realhuno/Chorus32-ESP32LapTimer/pcb/smeat/esp32-wroom-timer-v1/esp32-wroom-timer_bottom.png

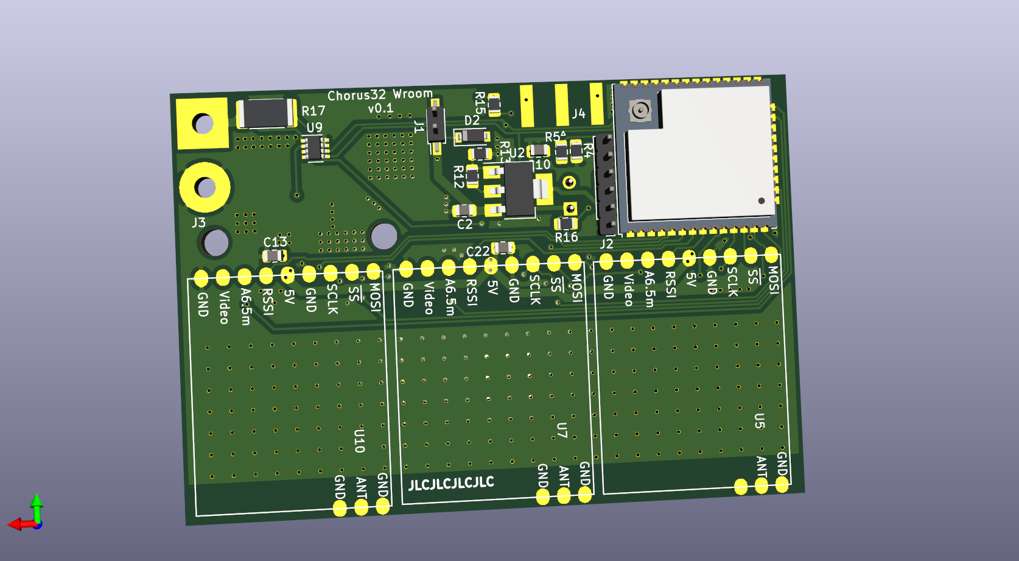
pcb/smeat/esp32-wroom-timer-v1/esp32-wroom-timer_bottom.png
