realhuno/Chorus32-ESP32LapTimer/ESP32LapTimer/src/targets/config_default.h

#define BEEPER 14

#define LEDs 12

#define BUTTON1 T7 // 27
#define BUTTON2 T4 // 13

#define CS1 16
#define CS2 5
#define CS3 4
#define CS4 15
#define CS5 25
#define CS6 26

#define ADC1 ADC1_CHANNEL_0
#define ADC2 ADC1_CHANNEL_3
#define ADC3 ADC1_CHANNEL_6
#define ADC4 ADC1_CHANNEL_7
#define ADC5 ADC1_CHANNEL_4
#define ADC6 ADC1_CHANNEL_5

#define ADC1_GPIO 36
#define ADC2_GPIO 39
#define ADC3_GPIO 34
#define ADC4_GPIO 35
#define ADC5_GPIO 32
#define ADC6_GPIO 33

#define OLED
#define OLED_SCL 21
#define OLED_SDA 22
