realhuno/Chorus32-ESP32LapTimer/LapRelay/HardwareConfig.h

#define MAX_UDP_CLIENTS 5
#define WIFI_AP_NAME "Chorus32 LapTimer Relay"
#define BLUETOOTH_NAME WIFI_AP_NAME

#define USE_BLUETOOTH
//#define USE_SERIAL

//#define OUTPUT_DEBUG
//#define INPUT_DEBUG


#define USE_LORA
#define LORA_SCK 5
#define LORA_MISO 19
#define LORA_MOSI 27
#define LORA_CS 18
#define LORA_RST 14
#define LORA_IRQ 26
#define LORA_FREQ 866E6
