realhuno/Chorus32-ESP32LapTimer/ESP32LapTimer/src/targets/config_ttgo_lora_v1.h

#define BEEPER 4

#define LEDs 2

#define USE_CLASSIC_BUTTONS

#define BUTTON1 13
#define BUTTON2 12

#define VRX_MOSI 23
#define VRX_SCK 25

#define CS1 16
#define CS2 4
#define CS3 4
#define CS4 4
#define CS5 4
#define CS6 4

#define ADC1 ADC1_CHANNEL_0
#define ADC2 ADC1_CHANNEL_3
#define ADC3 ADC1_CHANNEL_6
#define ADC4 ADC1_CHANNEL_5
#define ADC5 ADC1_CHANNEL_4
#define ADC6 ADC1_CHANNEL_7 // switched with adc 4 due to xtal

#define ADC1_GPIO 36
#define ADC2_GPIO 39
#define ADC3_GPIO 34
#define ADC4_GPIO 33
#define ADC5_GPIO 32
#define ADC6_GPIO 35

#define USE_LORA
#define LORA_SCK 5
#define LORA_MISO 19
#define LORA_MOSI 27
#define LORA_CS 18
#define LORA_RST 14
#define LORA_IRQ 26
#define LORA_FREQ 866E6
