realhuno/Chorus32-ESP32LapTimer/ESP32LapTimer/src/targets/config_wroom.h

#define BEEPER 18

#define LEDs 16

#define VRX_SCK 26
#define VRX_MOSI 14

#define CS1 25
#define CS2 27
#define CS3 13
#define CS4 12
#define CS5 15
#define CS6 2

#define ADC1 ADC1_CHANNEL_5
#define ADC2 ADC1_CHANNEL_4
#define ADC3 ADC1_CHANNEL_7
#define ADC4 ADC1_CHANNEL_6
#define ADC5 ADC1_CHANNEL_0
#define ADC6 ADC1_CHANNEL_3

#define ADC1_GPIO 33
#define ADC2_GPIO 32
#define ADC3_GPIO 35
#define ADC4_GPIO 34
#define ADC5_GPIO 36
#define ADC6_GPIO 39

#define I2C_SDA 23
#define I2C_SCL 22

#ifdef OLED
#undef OLED
#endif
