realhuno/Chorus32-ESP32LapTimer/ESP32LapTimer/src/targets/config_dev_board.h

#define BEEPER 0

#define LEDs 0

#define BUTTON1 T7 // 27
#define BUTTON2 T4 // 13

#define CS1 16
#define CS2 5
#define CS4 4
#define CS3 15
#define CS5 0
#define CS6 0

#define ADC1 ADC1_CHANNEL_0
#define ADC2 ADC1_CHANNEL_3
#define ADC4 ADC1_CHANNEL_6
#define ADC3 ADC1_CHANNEL_7
#define ADC5 ADC1_CHANNEL_7
#define ADC6 ADC1_CHANNEL_5

#define ADC1_GPIO 36
#define ADC2_GPIO 39
#define ADC3_GPIO 34
#define ADC4_GPIO 35
#define ADC5_GPIO 32
#define ADC6_GPIO 33

#define USE_LORA
#define LORA_SCK 17
#define LORA_MISO 32
#define LORA_MOSI 26
#define LORA_CS 12
#define LORA_RST 14
#define LORA_IRQ 25
#define LORA_FREQ 866E6
