realhuno/Chorus32-ESP32LapTimer/ESP32LapTimer/src/RX5808.cpp

#define SPI_ADDRESS_SYNTH_B 0x01
#define SPI_ADDRESS_POWER   0x0A
#define SPI_ADDRESS_STATE   0x0F

#define PowerDownState    0b11111111111111111111
#define DefaultPowerState 0b00010000110000010011

#define ResetReg          0b00000000000000000000
#define StandbyReg        0b00000000000000000010
#define PowerOnReg        0b00000000000000000001

#define PD_VCLAMP       0x00080000 /*Video clamp power down control */
#define PD_VAMP         0x00040000 /*Video amp power down control */
#define PD_IF_DEMOD     0x00020000 /*IF demodulator power down control */
#define PD_IFAF         0x00010000 /*IFAF power down control */
#define PD_RSSI_SQUELCH 0x00008000 /*RSSI & noise squelch power down control */
#define PD_REGBS        0x00004000 /*BS regulator power down control */
#define PD_REGIF        0x00002000 /*IF regulator power down control */
#define PD_BC           0x00001000 /*BC power down control */
#define PD_DIV4         0x00000800 /*Divide-by-4 power down control */
#define PD_5GVCO        0x00000400 /*5G VCO power down control */
#define PD_SYN          0x00000200 /*SYN power down control */
#define PD_AU6M         0x00000100 /*6M audio modulator power down control */
#define PD_6M           0x00000080 /*6M power down control */
#define PD_AU6M5        0x00000040 /*6M5 audio modulator power down control */
#define PD_6M5          0x00000020 /*6M5 power down control */
#define PD_REG1D8       0x00000010 /*1.8V regulator power down control */
#define PD_IFABF        0x00000008 /*IFABF power down control */
#define PD_MIXER        0x00000004 /*RF Mixer power down control */
#define PD_DIV80        0x00000002 /*Divide-by-80 power down control */
#define PD_PLL1D8       0x00000001 /*PLL 1.8V regulator power down control */

//                       PD_VCLAMP | PD_VAMP | PD_IF_DEMOD | PD_IFAF | PD_REGIF | PD_DIV4 | PD_5GVCO | PD_SYN | PD_AU6M | PD_6M | PD_AU6M5 | PD_6M5 | PD_REG1D8 | PD_IFABF | PD_MIXER | PD_DIV80 | PD_PLL1D8

// PD_IF_DEMOD, PD_REGIF, PD_IFABF, PD_MIXER, PD_REGBS, PD_RSSI_SQUELCH, PD_BC breaks rssi
// PD_SYN decreases rssi extremely. not really usable
// saves about 10mA
#define LOW_POWER_STATE (PD_VCLAMP | PD_VAMP | PD_IFAF | PD_DIV4 | PD_5GVCO | PD_AU6M | PD_6M | PD_AU6M5 | PD_6M5 | PD_REG1D8 | PD_DIV80 | PD_PLL1D8)

#include "RX5808.h"

#include "HardwareConfig.h"
#include "settings_eeprom.h"

#include <Arduino.h>
#include <stdint.h>
#include <SPI.h>
#include <driver/timer.h>

static volatile uint8_t RXBandModule[MAX_NUM_RECEIVERS];
static volatile uint8_t RXChannelModule[MAX_NUM_RECEIVERS];

// TODO: this doesn't really belong here
static volatile uint8_t RXBandPilot[MAX_NUM_PILOTS];
static volatile uint8_t RXChannelPilot[MAX_NUM_PILOTS];

static uint32_t lastUpdate[MAX_NUM_RECEIVERS] = {0,0,0,0,0,0};

void InitSPI() {
  SPI.begin(VRX_SCK, VRX_MISO, VRX_MOSI);
  delay(200);
  // Reset all modules to ensure they come back online in case they were offline without a power cycle (pressing the reset button)
  RXResetAll();
  delay(30);
  rxLowPowerAll();
  delay(30);
}

bool IRAM_ATTR isRxReady(uint8_t module) {
  return (micros() - lastUpdate[module]) > MIN_TUNE_TIME_US;
}

void rxWrite(uint8_t addressBits, uint32_t dataBits, uint8_t CSpin) {

  uint32_t data = addressBits | (1 << 4) | (dataBits << 5);
  SPI.beginTransaction(SPISettings(1000000, LSBFIRST, SPI_MODE0));
  digitalWrite(CSpin, LOW);
  SPI.transferBits(data, NULL, 25);

  digitalWrite(CSpin, HIGH);
  SPI.endTransaction();
}

void rxWriteNode(uint8_t node, uint8_t addressBits, uint32_t dataBits) {
  if (node < MAX_NUM_RECEIVERS) {
    lastUpdate[node] = micros();
    rxWrite(addressBits, dataBits, CS_PINS[node]);
  }
}

void rxLowPower(uint8_t node) {
#ifdef USE_LOW_POWER
  rxWriteNode(node, SPI_ADDRESS_POWER, LOW_POWER_STATE);
#endif
}


void rxWriteAll(uint8_t addressBits, uint32_t dataBits) {

  uint32_t data = addressBits | (1 << 4) | (dataBits << 5);
  SPI.beginTransaction(SPISettings(1000000, LSBFIRST, SPI_MODE0));
  for(int i = 0; i < MAX_NUM_RECEIVERS; i++) {
    digitalWrite(CS_PINS[i], LOW);
  }

  SPI.transferBits(data, NULL, 25);

  delayMicroseconds(MIN_TUNE_TIME_US);

  for(int i = 0; i < MAX_NUM_RECEIVERS; i++) {
    digitalWrite(CS_PINS[i], HIGH);
  }

  SPI.endTransaction();

}

void RXstandBy(uint8_t NodeAddr) {
  rxWriteNode(NodeAddr, SPI_ADDRESS_STATE, StandbyReg);
}

void RXpowerOn(uint8_t NodeAddr) {
  rxWriteNode(NodeAddr, SPI_ADDRESS_STATE, PowerOnReg);
}

void RXreset(uint8_t NodeAddr) {
  rxWriteNode(NodeAddr, SPI_ADDRESS_STATE, ResetReg);
}

void RXResetAll() {
  for (int i = 0; i < getNumReceivers(); i++) {
    RXreset(i);
  }
}

void rxLowPowerAll() {
  for (int i = 0; i < getNumReceivers(); i++) {
    rxLowPower(i);
  }
}


void RXPowerDownAll() {
  //for (int i = 0; i < getNumReceivers(); i++) {
  //rxWrite(SPI_ADDRESS_POWER, PowerDownState, i);
  //RXstandBy(i);
  //delay(100);
  //}
  rxWriteAll(SPI_ADDRESS_POWER, PowerDownState);
}

void RXPowerDown(uint8_t NodeAddr) {
  rxWriteNode(NodeAddr, SPI_ADDRESS_POWER, PowerDownState);
}

void RXPowerUpAll() {
  for (int i = 0; i < getNumReceivers(); i++) {
    rxWrite(SPI_ADDRESS_POWER, DefaultPowerState, i);
  }
}

void RXPowerUp(uint8_t NodeAddr) {
  rxWriteNode(NodeAddr, SPI_ADDRESS_POWER, DefaultPowerState);
}

void SelectivePowerUp() { //powerup only the RXs that have been requested
  for (int i = 0; i < getNumReceivers(); i++) {
    RXreset(i);
    //RXstandBy(i);
    delay(50);
    RXpowerOn(i);
    //PowerUp(i);
    rxWrite(SPI_ADDRESS_POWER, DefaultPowerState, i);
//
//    Serial.print("Power up: ");
//    Serial.println(i);
  }
}

uint16_t getSynthRegisterBFreq(uint16_t f) {
  return ((((f - 479) / 2) / 32) << 7) | (((f - 479) / 2) % 32);
}


void setChannel(uint8_t channel, uint8_t NodeAddr) {
  if (channel <= 7) {
    RXChannelModule[NodeAddr] = channel;
    uint8_t band = RXBandModule[NodeAddr];
    uint16_t SetFreq = setModuleChannelBand(channel, band, NodeAddr);
    (void)SetFreq;
  }
}

void setBand(uint8_t band, uint8_t NodeAddr) {
  if (band <= MAX_BAND) {
    RXBandModule[NodeAddr] = band;
    uint8_t channel = RXChannelModule[NodeAddr];
    uint16_t SetFreq = setModuleChannelBand(channel, band, NodeAddr);
    (void)SetFreq;
  }
}

uint16_t setModuleChannelBand(uint8_t NodeAddr) {
  return setModuleChannelBand(RXChannelModule[NodeAddr], RXBandModule[NodeAddr], NodeAddr);
}

uint16_t setModuleChannelBand(uint8_t channel, uint8_t band, uint8_t NodeAddr) {  
  uint8_t index = channel + (8 * band);
  uint16_t frequency = channelFreqTable[index];
  RXBandModule[NodeAddr] = band;
  RXChannelModule[NodeAddr] = channel;
  return setModuleFrequency(frequency, NodeAddr);
}

uint16_t setModuleFrequency(uint16_t frequency, uint8_t NodeAddr) {
  rxWriteNode(NodeAddr, SPI_ADDRESS_SYNTH_B, getSynthRegisterBFreq(frequency));
  return frequency;
}

uint16_t setModuleFrequencyAll(uint16_t frequency) {
  rxWriteAll(SPI_ADDRESS_SYNTH_B, getSynthRegisterBFreq(frequency));
  return frequency;
}

String getBandLabel(int band) {
  switch (band) {
    case 0:
      return "R";
      break;
    case 1:
      return "A";
      break;
    case 2:
      return "B";
      break;
    case 3:
      return "E";
      break;
    case 4:
      return "F";
      break;
    case 5:
      return "D";
      break;
    case 6:
      return "X";
      break;
    case 7:
      return "XX";
      break;
    default:
      return "";
      break;
  }
}

void setRXBandPilot(uint8_t pilot, uint8_t band) {
  RXBandPilot[pilot] = band;
}
uint8_t getRXBandPilot(uint8_t pilot) {
  return RXBandPilot[pilot];
}

void setRXChannelPilot(uint8_t pilot, uint8_t channel) {
  if(pilot < MAX_NUM_PILOTS) {
    RXChannelPilot[pilot] = channel;
  }
}
uint8_t getRXChannelPilot(uint8_t pilot) {
  return RXChannelPilot[pilot];
}

void setRXBandModule(uint8_t module, uint8_t band) {
  RXBandModule[module] = band;
}
uint8_t getRXBandModule(uint8_t module) {
  return RXBandModule[module];
}

void setRXChannelModule(uint8_t module, uint8_t channel) {
  RXChannelModule[module] = channel;
}
uint8_t getRXChannelModule(uint8_t module) {
  return RXChannelModule[module];
}
