realhuno/Chorus32-ESP32LapTimer/ESP32LapTimer/src/Timer.h

#ifndef TIMER_H
#define TIMER_H


#include <stdint.h>


class Timer {
    private:
        uint32_t nextTick;
        uint16_t delay;
        bool ticked;

    public:
        Timer(uint16_t delay);
        bool hasTicked();
        void reset();
};


#endif
