realhuno/Chorus32-ESP32LapTimer/(commit log)

2019-06-08 Fix adc reading.
2019-06-10 Characterize adc to fight the non-linearity
2019-06-10 Allow the use of normal input buttons.
2019-06-10 Skip ADC calibration for voltage reading channel.
    [ADC.ino]
2019-06-15 [WIP] Use proper C. TODO: Remove all remaining externs. Rename all .ino files to cpp Fix circular dependencies.
    [ADC.cpp, ADC.h, Buttons.ino, Calibration.cpp, Comms.h, Comms.ino, ESP32LapTimer.ino]
2019-06-16 Convert Buttons
2019-06-17 Remove filter and vbat externs. Some cleanup. Remove binary file.
2019-06-17 Fix getLaptime. I should add a Makefile to prevent those errors.
    [Laptime.cpp]
2019-06-17 Print to serial if udp buf is full.
2019-06-17 Sample ADC with 6khz but only one channel at a time. So we have 1khz per channel.
2019-06-17 Add LIKELY and UNLIKELY macros. Fix Utils.h
    [ADC.cpp, ESP32LapTimer.ino, Utils.cpp, Utils.h]
2019-06-17 Only check the threshold for the current node.
2019-06-17 Don't sleep when switching vrx channels.
2019-06-18 Replace static filters with dynamic ones.
    [ADC.cpp, Filter.cpp, Filter.h, RX5808.cpp]
2019-06-18 Remove debug print.
2019-07-20 Fix adc voltage reading.
    [ADC.cpp]
2019-07-20 Use a filter for voltage readings.
2019-07-20 Make voltage update rate configurable. It is way easier to read the voltage this way.
2019-07-20 Add supersampling for adc voltage reading.
2019-07-20 Refactor input and oled. Fixes #1.
    [OLED.cpp]
2019-07-20 Fix node 0 on the initial load.
    [ADC.cpp]
2019-07-20 Improve filtering when multiplexing.
2019-07-20 Adjust filter depending on number of clients.
2019-07-20 Filter adc freq on oled.
2019-07-20 Add switchable filter output.
2019-07-20 Allow for setting more than 6 pilots. Fix various instances of wrong comparisons.
    [ADC.cpp, ADC.h, Buttons.cpp, Comms.cpp, ESP32LapTimer.ino, RX5808.cpp, settings_eeprom.cpp, settings_eeprom.h]
2019-07-20 Support multiple pages for the summary page. Skip inactive pilots.
    [OLED.cpp, OLED.h]
2019-07-20 Fix module calls and remove unused variable from eeprom.
    [Comms.cpp, WebServer.cpp, settings_eeprom.cpp, settings_eeprom.h]
2019-07-20 Move skipfirstlap variable and check it when calculating the best lap.
    [Comms.cpp, Laptime.cpp, Laptime.h]
2019-07-20 Fix selecting skip first lap in app.
    [Comms.cpp, Laptime.cpp, Laptime.h]
2019-07-20 Fix lap times page.
    [OLED.cpp]
2019-07-20 Go to prev page on long button1.
2019-07-20 Fix the reliability of startup by forcing multiplexing by default.
    [ADC.cpp, ESP32LapTimer.ino]
2019-07-20 Fix eeprom loading location. This fixes bringing up the module without multiplexing. By default pilots equal to the number of modules are active.
    [ADC.cpp, Comms.cpp, ESP32LapTimer.ino, RX5808.cpp]
2019-07-20 Add debug output and input switches
2019-07-20 Remove multisampling for voltage reading. Thanks @AlessandroAU.
2019-07-20 Power down unused modules to save power.
2019-07-20 Refactor RX5808 settings. Requires far less switch statements.
2019-07-20 Remove NUM_PHYSICAL_RECEIVERS and replace extern NumReceivers with a function. Closes #3.
    [ADC.cpp, Calibration.cpp, Comms.cpp, ESP32LapTimer.ino, HardwareConfig.h, Laptime.cpp, OLED.cpp, RX5808.cpp]
2019-07-20 Fix check of calibration logic.
    [ADC.cpp]
2019-07-20 Fix default for wifi settings.
    [settings_eeprom.cpp]
2019-07-20 Fix compilation without lora
    [Lora.cpp]
2019-07-20 Force a pilot to wait a minimum time for a module. This ensures there is no constant switching when there are almost as many pilots as modules.
2019-07-20 Remove multiplex function as I discarded the queue idea. Fix compilation.
    [ADC.cpp]
2019-07-20 Remove non multiplexing special case. Now we just won't switch receivers when there are enough. Also allows to use e.g. pilot 2 and 3 with only 2 receivers and no multiplexing.
    [ADC.cpp]
2019-07-20 Fix filter dt when not multiplexing.
    [ADC.cpp]
2019-07-20 Count frequency of adc using pilot 0
2019-07-20 Fix non multiplexing case.
    [ADC.cpp]
2019-07-20 Fix various race conditions. Save the current pilot and rx as pointer.
    [ADC.cpp]
2019-07-20 Remove debug prints.
2019-07-20 Automatically disable all modules upon start when the voltage is too low. e.g. connecting via USB.
    [ADC.cpp, ADC.h, HardwareConfig.h, settings_eeprom.cpp, settings_eeprom.h]
2019-07-20 Power down all modules on startup.
2019-07-20 Only power the bare minimum for getting rssi.
2019-07-20 Make low power a compile time option. Low power increases the tune time and makes multiplexing worse.
2019-07-20 Don't adjust filter when multiplexing.
2019-07-20 Allow any number as filter cutoff.
2019-07-20 Only power up configured modules.
2019-07-20 Small cleanup in ADC.
2019-07-20 Prevent false early triggering of a lap (threshold test)
    [ADC.cpp]
2019-07-20 Fix debug output. Whoops, thats why I had an offset.
    [ADC.cpp]
2019-07-20 Add support for multiple lowpass filters and specifying a separate sampling rate.
2019-07-20 Add support for comparing the data with a butterworth and bessel filter from scipy
2019-07-20 Add support for dropping samples.
2019-07-27 Add very simple multiplexing for a single module.
    Don't sleep when switching vrx channels.
    Replace static filters with dynamic ones.
    Multiple modules should work with multiplexing.
    Remove debug print.
    Disable multiplexing when enough modules are present.
    Refactor input and oled.
    [ADC.cpp, Comms.cpp, Filter.cpp, Filter.h, HardwareConfig.h, OLED.cpp, RX5808.cpp, RX5808.h]
2019-07-27 Only power the bare minimum for getting rssi.
    Make low power a compile time option.
    Low power increases the tune time and makes multiplexing worse.
2019-07-27 Disable min voltage by default
2019-07-27 Fix calibration and add workaround when changing the frequency
    [ADC.h, Calibration.cpp, Comms.cpp]
2019-07-27 Multisample rssi during calibration and wait for rx to be ready.
2019-07-27 Stop adc reading on core 0 when calibrating. Move calibration to core 0.
2019-07-27 Add calibration progress to OLED
2019-07-27 Fix applying band and channel without multiplexing.
    [ADC.cpp, ADC.h, Comms.cpp, WebServer.cpp]
2019-07-27 Fix laptimes being 0.
    [ADC.cpp, HardwareConfig.h]
2019-07-27 Fix threshold being float on website
    [WebServer.cpp]
2019-07-27 Fix bug when using the webpage to change pilot settings All pilots would get activated, regardless of settings.
    [ADC.cpp]
2019-07-28 Use socket funtions directly for UDP Prevents the repeated memory allocation by parsePacket and saves 1.4KB of memory.
    [UDP.cpp]
2019-07-28 Fix duplicate lap sending.
    [ADC.cpp]
2019-08-17 First version of small PCB with 6 modules and LoRa support.
    [esp32-wroom-timer.kicad_pcb, esp32-wroom-timer.sch]
2019-08-17 Possibly the final version(?)
    [esp32-wroom-timer.kicad_pcb, esp32-wroom-timer.sch]
2019-08-22 Fix calibration with multiplexing This stops adc reading and calibrates on core 0
    [ADC.cpp, ADC.h, Calibration.cpp, ESP32LapTimer.ino]
2019-08-22 Some smaller fixes after rebase.
    [Calibration.cpp, ESP32LapTimer.ino]
2019-08-22 Add support for LoRa communication.
    Fix compilation without lora
    [HardwareConfig.h, Lora.cpp, Lora.h, Output.cpp, config_ttgo_lora_v1.h]
2019-08-22 [SCRIPT] Add support for multiple lowpass filters and specifying a separate sampling rate.
2019-08-22 [SCRIPT] Add support for comparing the data with a butterworth and bessel filter from scipy
2019-08-22 [SCRIPT] Add support for dropping samples.
2019-08-22 Add LapRelay program. Used as a relay for LoRa.
2019-08-22 Disable all modules on brownout reboot.
    [ADC.cpp, ADC.h, ESP32LapTimer.ino]
2019-08-22 Fix brownout logic and reenable minimum voltage default Otherwise I am unable to use my module to develop.
    [ESP32LapTimer.ino, HardwareConfig.h]
2019-08-22 Show current race status and save last selected values
2019-08-22 Make changes to my dev board I need to finish this pcb :/
2019-08-22 Add my PCB It takes an input voltage of 5V-26V, has space for 6 modules, an optional LoRa module, ina219, buzzer, fan pads, optional temperature sensor to control the fan. It uses an esp32 wroom 32u 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
    [esp32-wroom-timer.kicad_pcb, esp32-wroom-timer.sch]
2019-08-22 Add CERN OHL for my PCB
2019-08-22 Add safety pullup resistors for i2c
    [esp32-wroom-timer.kicad_pcb, esp32-wroom-timer.sch]
2019-08-22 Last minute PCB changes I hate those :/
    [esp32-wroom-timer.kicad_pcb, esp32-wroom-timer.sch]
2019-08-22 Fix invalid json with no active pilots.
    [WebServer.cpp]
2019-08-22 Add more responsive settings for adc Others will follow.
2019-08-22 Migrate filter settings
2019-08-22 Fix reset button.
2019-08-22 Use websockets for voltage.
2019-08-22 Migrate the rest of the settings to websockets only calibration is missing but the redirect isn't that bad on this one.
    [ADC.cpp, ADC.h, Comms.cpp, WebServer.cpp]
2019-08-22 Fix voltage reading
2019-08-22 Fix voltage scaling
2019-08-22 Make the settings page more useable on a mobile device Probably still awful
2019-08-23 Add basic info about calibration. CSS is still TODO
2019-08-24 Fix off by one error in queue.
    [Queue.c]
2019-08-24 Fix oled scrolling on summary page
    [OLED.cpp]
2019-12-24 Add config file for my pcb
2019-12-24 Add README for my new pcb
2019-12-24 [PCB] Fix resistor value
    [esp32-wroom-timer.sch]
2019-12-24 [PCB] Add picture
2019-12-24 Make I2C pins configurable
2019-12-24 Disable display support for my board
2019-12-24 Enable ArduinoOTA as a fallback update mechanism
2019-12-24 Refactor beeper code. Doesn't include any delays now.
    [Beeper.cpp, Beeper.h, ESP32LapTimer.cpp]
2019-12-24 Fix compilation with enabled buttons.
    [Buttons.cpp]
2019-12-24 Change upload speed to match the one from Arduino
2019-12-24 Simplify platformio config and add custom partition scheme
    [timer_partitions.csv]
2019-12-24 Update calibration values after calibrating without reloading
2019-12-29 Remove old functions Json is now replaced by websockets. Sending update status is not needed as the client can see the progress itself.
    [Comms.cpp, Comms.h, TimerWebServer.cpp]
2019-12-29 Add Travis CI and fix LoRa boards
    [config_ttgo_lora_v1.h]
2020-03-02 Prevent overflow with too many laps Old laps are now phased out
    [Laptime.cpp]
2020-03-02 Revert "Prevent overflow with too many laps"
    This reverts commit 2f0e90db10a660fb202e8f73e742baf088e25ff9.
    I don't really like memmove on the critical path. This might impact timing performance, and 100 laps should be enough. If you are in training you'll just have to restart eventually
    [Laptime.cpp]
2020-03-07 Update partition scheme (need to reflash using uartgit add -p .) eeprom is not used anymore.
    [timer_partitions.csv]
2020-03-09 Add crash detection which will boot in OTA only mode on > 5 crashes.
    [Buttons.cpp, CrashDetection.cpp, CrashDetection.h, ESP32LapTimer.cpp, TimerWebServer.cpp]
2020-03-09 Fix i2c pins for default board
    [config_default.h]
2020-03-09 Disable update firmware button until a file is selected
2020-03-12 Add getter for filter value
2020-03-14 Fix Terminator for bulk messages Thank you @realhuno
    [Comms.cpp]
2020-03-14 Fix enumeration According to the documentation only the highest value is sent. Fixes compatability with racegod Thank you @realhuno
    [Comms.cpp]
2020-03-30 Fix OLED pins Not sure, what the problem was. Maybe a clash with the ina219? @realhuno finding all the bugs :D
    [OLED.cpp, config_default.h]
2020-04-15 Add data prepare script to pio and fix some issues
    [prepare_data.py]
2020-06-09 basic mqtt and rotorhazard support
